miclle/cabinet/references/README.md

# 唱片机柜参考图片

本目录保存用户提供的柜子参考图，作为外观、分区及工艺讨论依据。图片原文件名标注来自小红书作者「四碗饭」，主题为「黑胶唱片机柜，大约可以放300张碟子」；目前没有原帖链接。保留图片中的文字与水印，未修改图片内容。

## 图片索引

命名采用 `原序号-英文内容描述.jpg`。原始资料没有第 9 张，保留编号空缺，不将其余图片前移。

原文件名统一为 `黑胶唱片机柜，大约可以放300张碟子_<序号>_四碗饭_来自小红书网页版.jpg`。

| 原序号 | 当前文件 | 内容与用途 |
|---|---|---|
| 1 | [01-cabinet-styled-front-angle.jpg](01-cabinet-styled-front-angle.jpg) | 搭配唱片机与音箱的正面斜视，整体风格参考 |
| 2 | [02-cabinet-front-view.jpg](02-cabinet-front-view.jpg) | 空柜正视，观察分区及立面比例 |
| 3 | [03-cabinet-open-door-angle.jpg](03-cabinet-open-door-angle.jpg) | 开门斜视，观察层板、门扇及侧板 |
| 4 | [04-cabinet-rear-layout-cable-clips.jpg](04-cabinet-rear-layout-cable-clips.jpg) | 背面分区与理线夹 |
| 5 | [05-cabinet-living-room-scene.jpg](05-cabinet-living-room-scene.jpg) | 客厅使用场景与人体比例参考，不能据此确定尺寸 |
| 6 | [06-cabinet-open-door-speaker-scene.jpg](06-cabinet-open-door-speaker-scene.jpg) | 开门状态的设备与音箱搭配 |
| 7 | [07-cabinet-storage-layout.jpg](07-cabinet-storage-layout.jpg) | 顶部唱片槽、左下抽屉及右侧设备／唱片格的用途说明 |
| 8 | [08-cabinet-styled-front-wide.jpg](08-cabinet-styled-front-wide.jpg) | 较完整的正面场景，观察底部留空与两侧落地板 |
| 10 | [10-cabinet-front-side-panel.jpg](10-cabinet-front-side-panel.jpg) | 正面斜视，观察整块侧板、圆角及门框 |
| 11 | [11-record-bin-top-detail.jpg](11-record-bin-top-detail.jpg) | 顶部唱片槽与分隔杆 |
| 12 | [12-record-bin-brass-divider-detail.jpg](12-record-bin-brass-divider-detail.jpg) | 铜色分隔杆及端部安装细节；图中文字称为铜件 |
| 13 | [13-slatted-door-detail.jpg](13-slatted-door-detail.jpg) | 竖向格栅木条、间距与圆弧表面 |
| 14 | [14-slatted-door-mortise-tenon-detail.jpg](14-slatted-door-mortise-tenon-detail.jpg) | 木条端部与门框榫接细节 |

## 初步结构判断

- **外观**：胡桃木色，左右连续侧板向下落地、向上略高出台面；前后上角圆润。第 3、4、10 张结合观察，侧板靠墙后端略高，背部横向构件的上沿低于侧板后端；照片有透视，不能据此量出准确高差。左侧横向木纹面板与右侧细密竖格栅构成立面对比，下部横梁和离地留空使外形较轻。
- **左上**：从顶部取放的唱片槽，前挡板遮住唱片下半部，内部有两根铜色分隔杆。没有证据表明它是抽屉。
- **左下**：用于唱片的拉出式抽屉，上方留出封面展示和取放开口；用途由第 7 张的文字说明支持，抽屉滑轨与内部构造未展示。
- **右上**：唱片机置于顶面；格栅门后上层原用于功放。
- **右下**：格栅门后的唱片竖放区；门在右侧开启，五金型号、开角及安装尺寸未知。
- **背面**：设备区大面积敞开，左侧唱片区可见挡板，顶部／底部横向构件上设理线夹。需要另外确定抗侧向变形的连接方式，不能将敞背照片直接当作完整结构图。
- **材料与工艺**：图片文字宣称北美黑胡桃原木、铜件及格栅榫接；细节图能观察到木条端部嵌入门框，但无法由照片核实全部材质、榫深或胶合方式。

## 与目标唱片机的适配

2026-10-12 核对了[目标唱片机项目](https://github.com/miclle/vinyl-record-player)的 `main`，版本为 `83f002c90ee65a06adc0de353f203472fbe2baea`；本地对应 checkout 的 HEAD 相同且无未提交变更。

依据该版本的 [README](https://github.com/miclle/vinyl-record-player/blob/83f002c90ee65a06adc0de353f203472fbe2baea/README.md)与参数资料：

| 项目 | 当前设计数据 | 对柜子的影响 |
|---|---|---|
| 唱片机宽度 | 450 mm | 右上台面必须按净可用宽度定尺寸，计入侧板、挡边与操作余量 |
| 箱体深度／总包络深度 | 350／363.8 mm | 总深含前侧铭牌和后凸合页，尚不含外接插头和线缆；不能只按 350 mm 定柜深 |
| 闭盖高度 | 210.7 mm | 柜面高度需结合实际操作位置确定 |
| 翻盖展示角 | 70° | 需要检查完整开盖轨迹与后挡板、墙面的关系；该角度并非实物限位／悬停验证 |
| 扬声器布局 | 两全频朝前，低音朝下 | 唱片机放在开放顶面，保留原脚垫，避免挡边遮住前声路或挤占底部空间 |
| 低音最低点距承托面 | 当前模型 19.5 mm | 不在机身下铺厚垫或加构件而侵占该间隙；柜面振动、共振及实际声效仍需试摆验证 |
| 后部接口 | 电源接口、倒相口等 | 后挡板和靠墙距离应按实物接线、倒相口位置与开盖包络共同核对 |

目标是一体式唱片机，自带功放与扬声器，因此参考柜右上内部的功放格可以保留外观分层，转作配件或唱片收纳；是否另放设备尚未确定。

## 下一步定尺寸的依据

优先保留侧板轮廓、左侧唱片槽／抽屉、右侧竖格栅门和胡桃木色关系，再按目标机器的实际包络调整宽深，避免按照片比例直接缩放。

作为后续草模的起点，可以先试右上净台面宽约 500～530 mm、有效承托深约 420～450 mm；这些是基于现有机身尺寸增加余量的设计假设，尚未做 CAD 或实物适配验证，也不是原柜尺寸。柜体总宽还需叠加左侧唱片区、侧板、中隔板和门框；总深还需计入后挡边等构件。柜面高度待结合使用者站姿／坐姿与开盖操作确定。

正式结构设计前需要补齐：

1. 摆放位置允许的总宽、总深、总高，以及背部靠墙条件。
2. 期望唱片容量、实际套封最大外廓、单／双碟与厚盒比例。原图标题的「约 300 张」仅为来源宣称，不能作为本柜容量结论。
3. 板材与实际厚度、连接工艺、格栅截面／间距、门与抽屉五金。承载需按唱片、设备和抽屉的实际重量核算。
4. 唱片机实物闭盖与开盖包络、插头突出长度、线缆弯曲空间、底部声路，以及抽屉拉出和门扇开启的空间。
5. 敞背柜体的抗侧向变形方案，满载抽屉拉出时的稳定性与防倾倒措施。

当前资料没有尺寸标注；以上分析不构成加工图或已验证的承载设计。

## 当前方案与参考图的差异

用户已要求柜子背后全部封闭。当前模型采用完整的 20 mm 厚背板，左右收纳区均封背；背板外表面按用户要求距侧板后沿内退 10 mm，位于 Y=430～450，内退量为当前方案值，并非照片实测；上文的敞背和理线横梁描述只记录原参考图片。侧板上沿先按前端名义高 810 mm、后部最高 830 mm（前 R20、后 R10，后立边顶高 820 mm），背板顶高 810 mm 建模，保留后端略高与背板退低的外观关系；两处 20 mm 高差为设计假设，非原柜实测。模型另有四个脚垫，左右侧板前后各一；暂按 Ø18×5 mm，侧板下缘离地 5 mm，柜体总高仍为 830 mm。圆角半径和脚垫尺寸均为设计值，非照片测量值。电源线现按背板上方绕出、沿背面三个开口理线夹向下走线加入方案占位；线材和夹子的实际规格尚未确认。当前布局与空间验证以项目根目录的 [README](../README.md) 为准。
