miclle/cabinet/designs/top-bin/previews/front.png

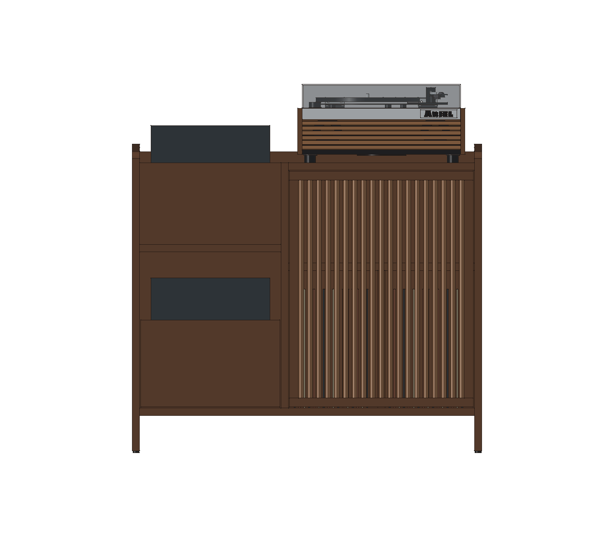
designs/top-bin/previews/front.png
