miclle/cabinet/designs/top-bin/previews/side-profile.png

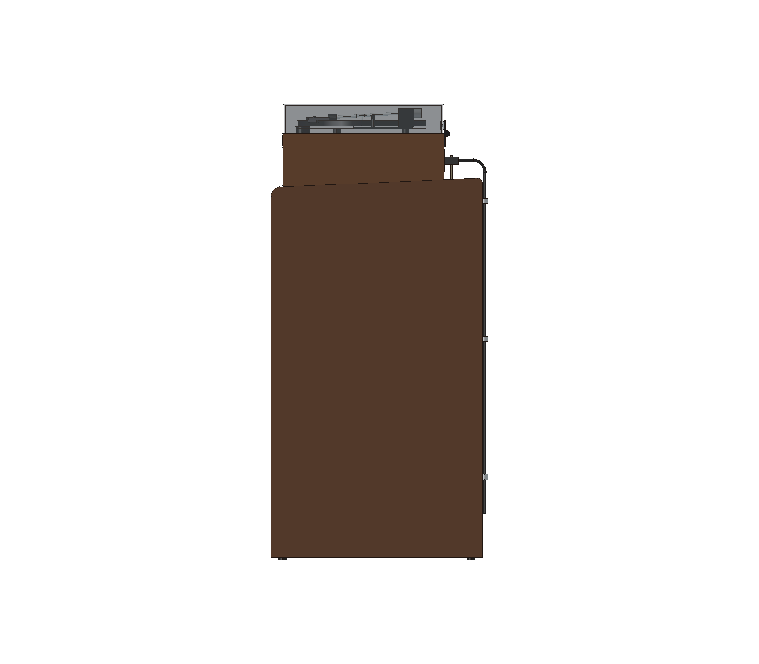
designs/top-bin/previews/side-profile.png
