miclle/cabinet/previews/foot-pads.png

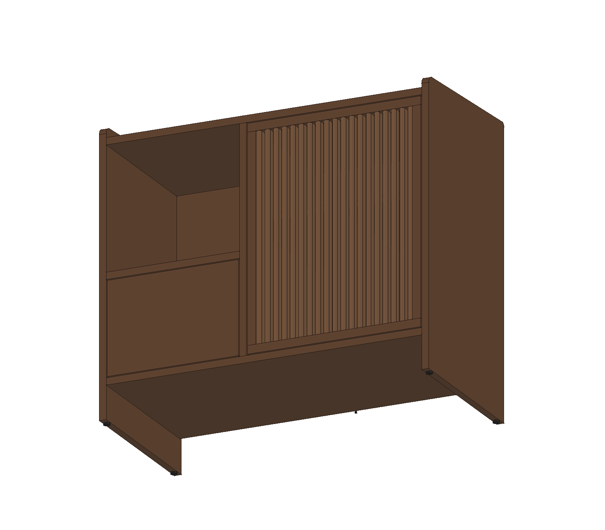
previews/foot-pads.png
