miclle/cabinet/previews/front.png

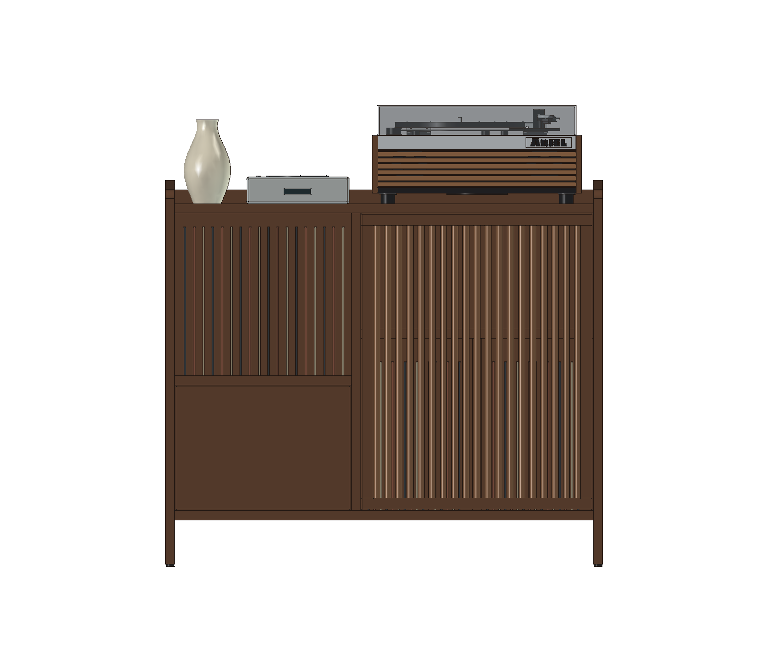
previews/front.png
