miclle/cabinet/previews/rear.png

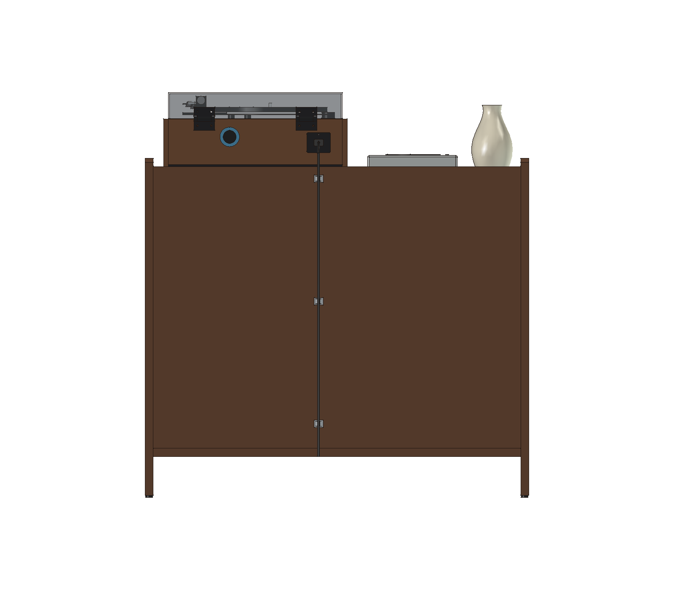
previews/rear.png
