miclle/cabinet/previews/storage-inspection.png

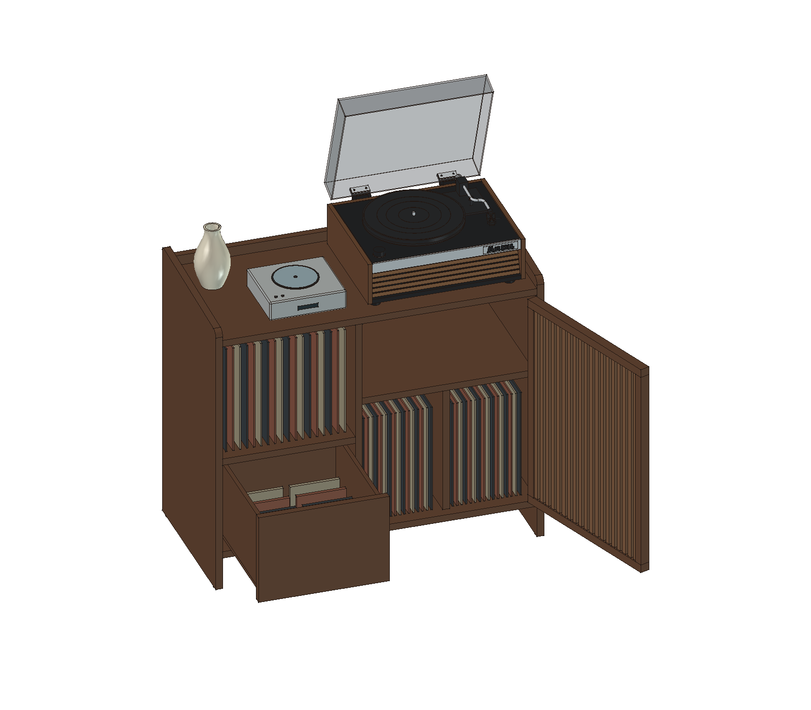
previews/storage-inspection.png
