miclle/cabinet/references/01-cabinet-styled-front-angle.jpg

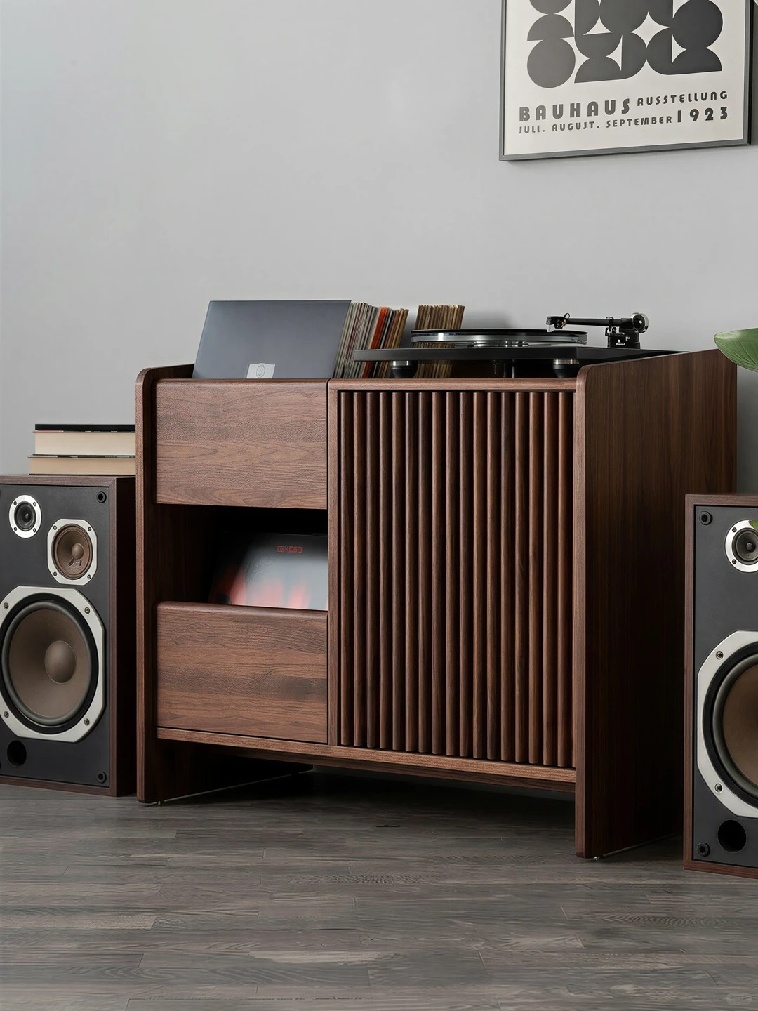
references/01-cabinet-styled-front-angle.jpg
