miclle/cabinet/references/02-cabinet-front-view.jpg

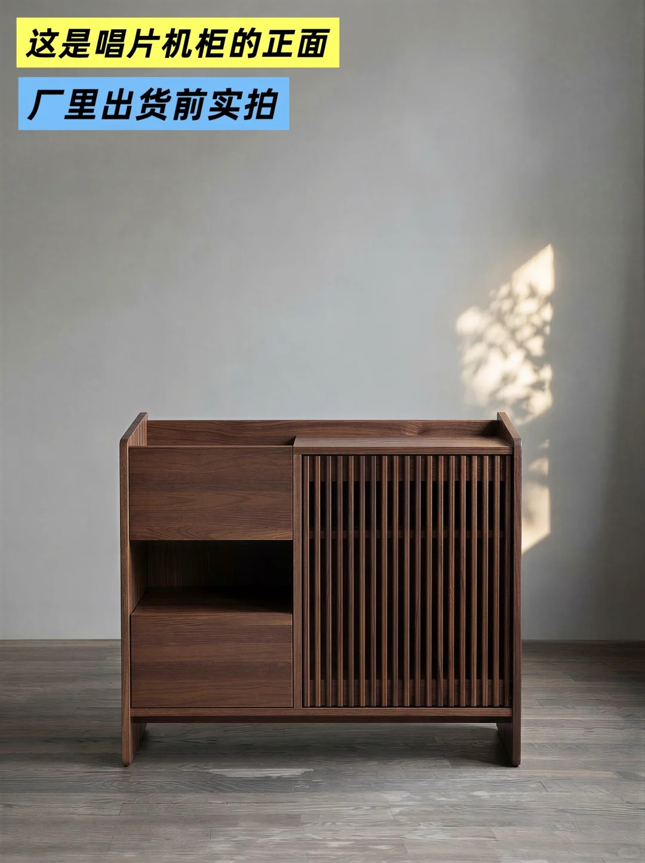
references/02-cabinet-front-view.jpg
