miclle/cabinet/references/03-cabinet-open-door-angle.jpg

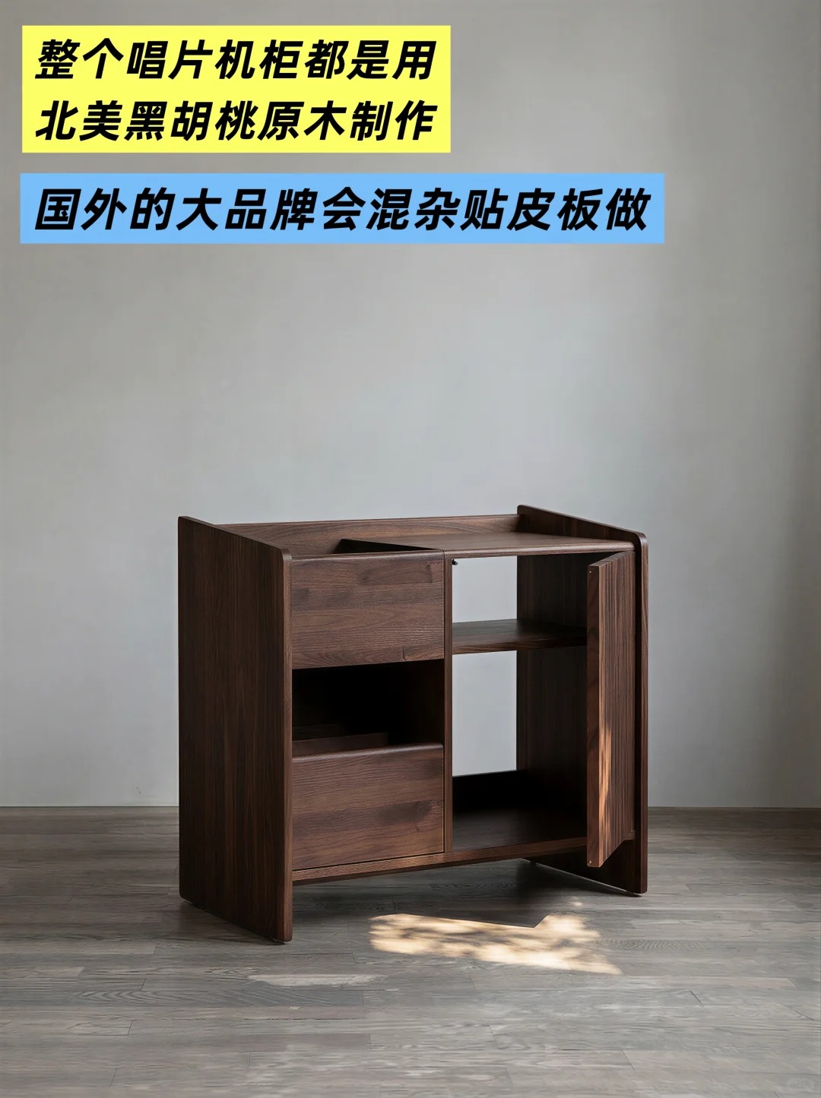
references/03-cabinet-open-door-angle.jpg
