miclle/cabinet/references/04-cabinet-rear-layout-cable-clips.jpg

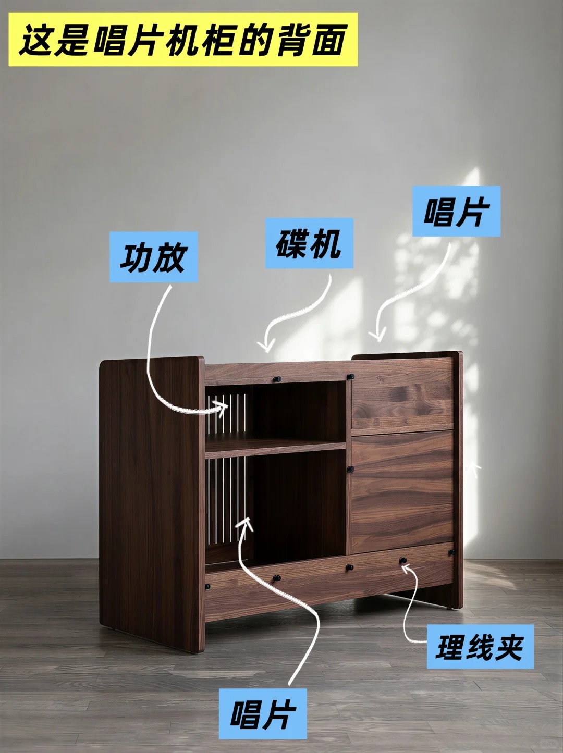
references/04-cabinet-rear-layout-cable-clips.jpg
