miclle/cabinet/references/05-cabinet-living-room-scene.jpg

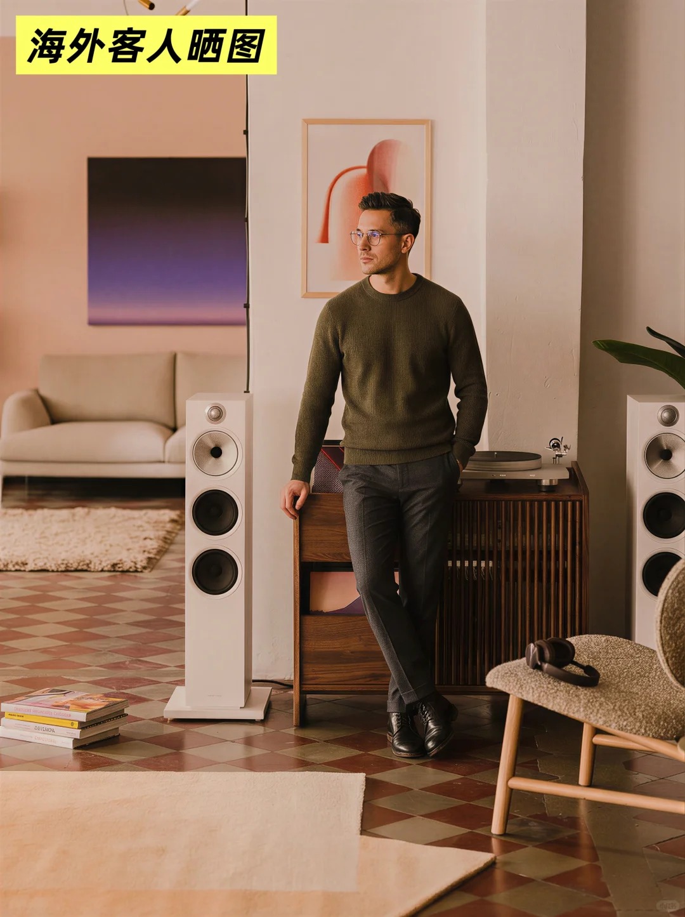
references/05-cabinet-living-room-scene.jpg
