miclle/cabinet/references/06-cabinet-open-door-speaker-scene.jpg

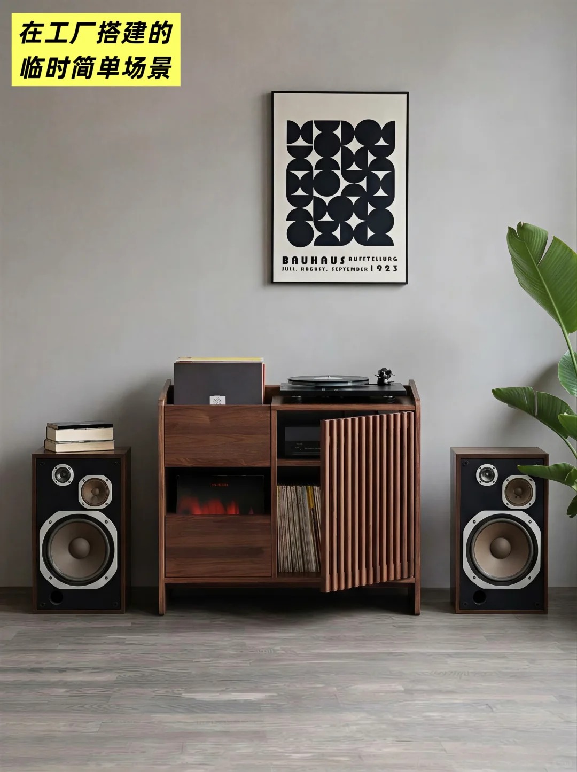
references/06-cabinet-open-door-speaker-scene.jpg
