miclle/cabinet/references/07-cabinet-storage-layout.jpg

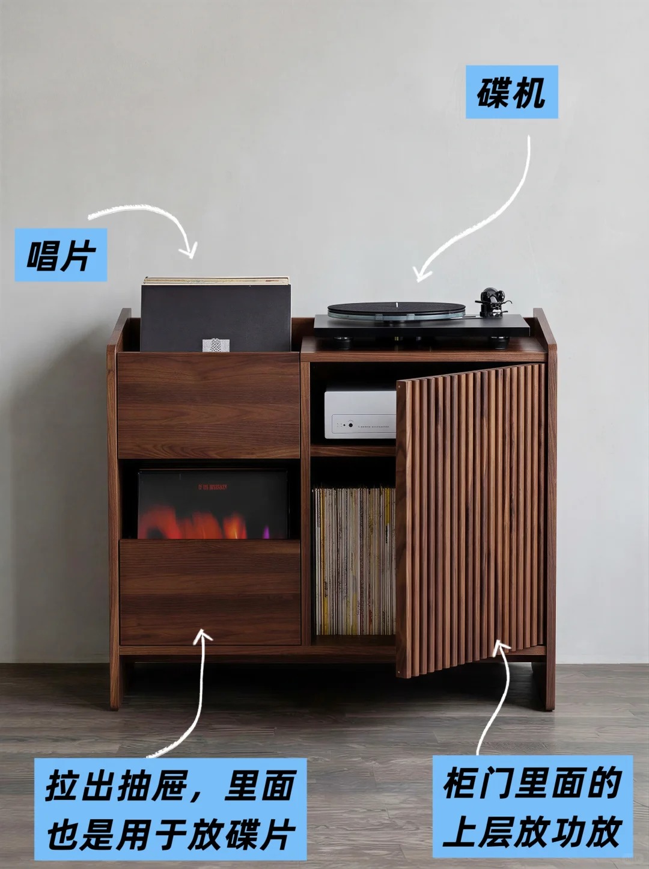
references/07-cabinet-storage-layout.jpg
