miclle/cabinet/references/08-cabinet-styled-front-wide.jpg

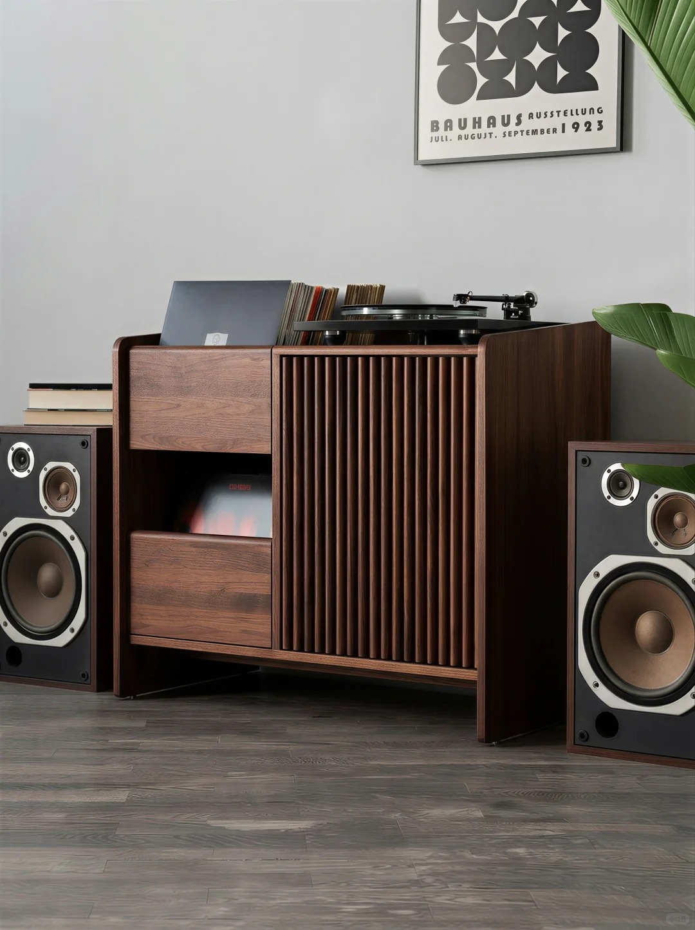
references/08-cabinet-styled-front-wide.jpg
