miclle/cabinet/references/10-cabinet-front-side-panel.jpg

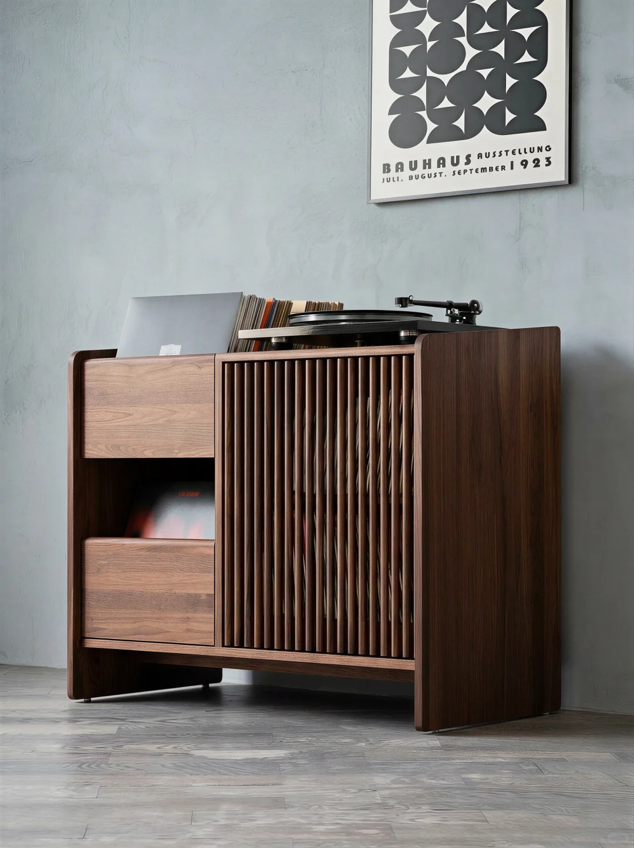
references/10-cabinet-front-side-panel.jpg
