miclle/cabinet/references/11-record-bin-top-detail.jpg

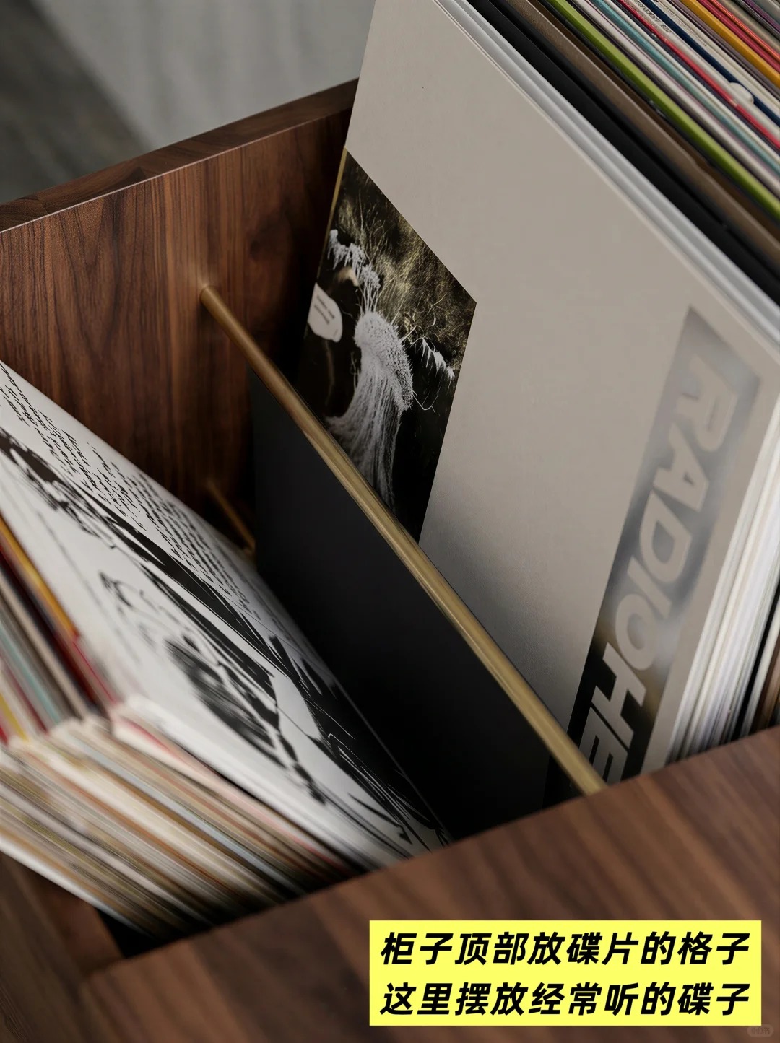
references/11-record-bin-top-detail.jpg
