miclle/cabinet/references/12-record-bin-brass-divider-detail.jpg

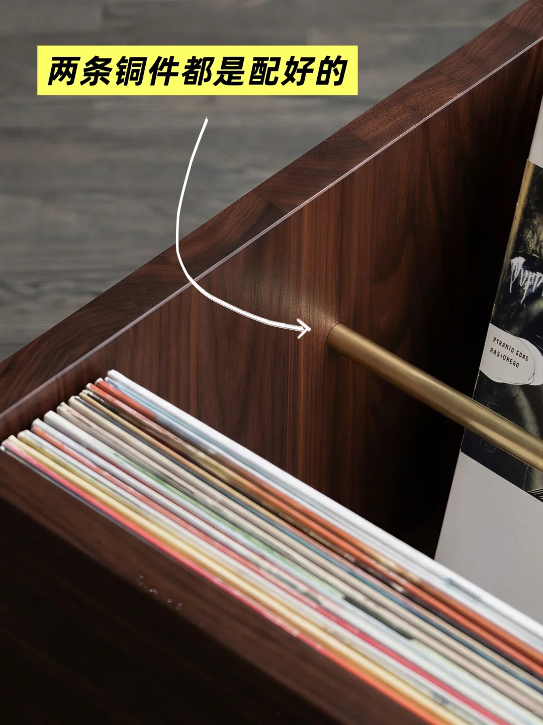
references/12-record-bin-brass-divider-detail.jpg
