miclle/cabinet/references/13-slatted-door-detail.jpg

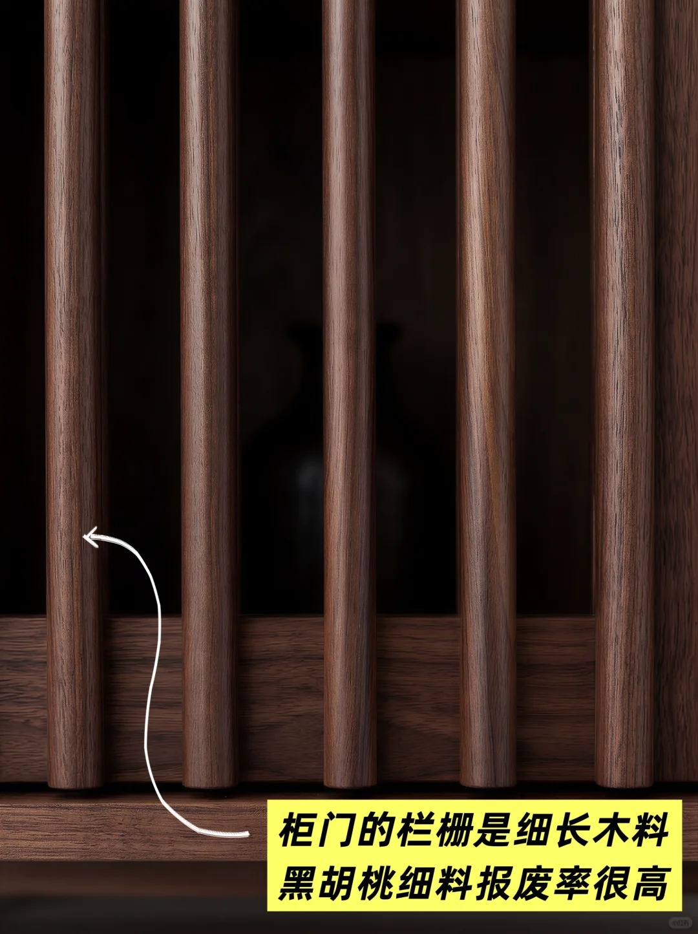
references/13-slatted-door-detail.jpg
