miclle/cabinet/references/14-slatted-door-mortise-tenon-detail.jpg

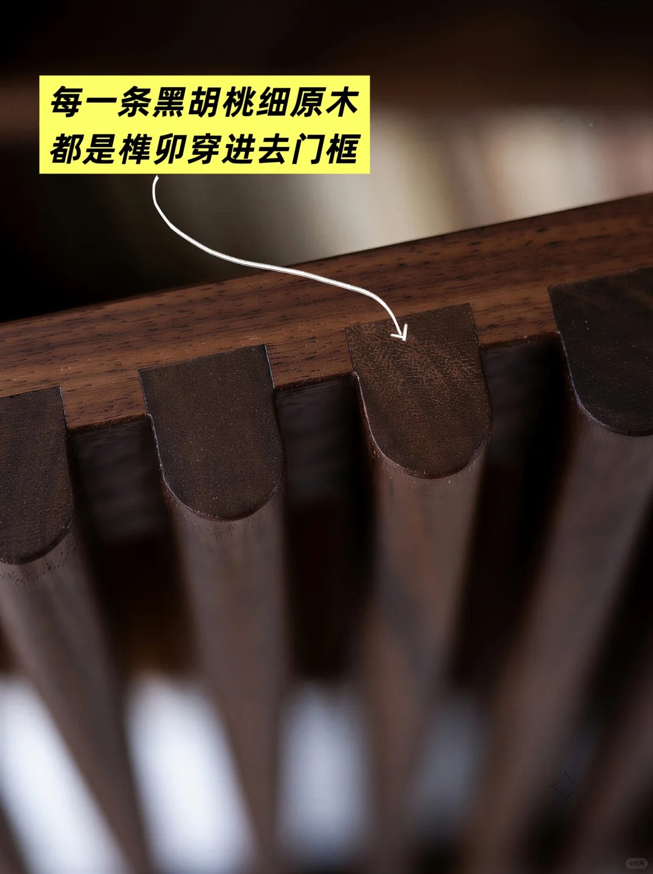
references/14-slatted-door-mortise-tenon-detail.jpg
