miclle/cabinet/designs/top-bin/docs/materials-and-hardware.md

# 方案A · 柜子板材尺寸与制作细化清单

本清单只描述顶部唱片槽方案A，恢复自`f6a8c35`交付；整台面方案B见[独立清单](../../../docs/materials-and-hardware.md)，整体差异见[双方案对比](../../../docs/design-comparison.md)。

本清单按当前 `940 × 460 × 830 mm` 方案整理，2026-10-14 从保存的 [cabinet.FCStd](../cad/cabinet.FCStd) 临时副本回读，统一恢复闭盖、关门、关抽屉姿态后核对尺寸。模型文件 SHA-256 为 `7d4d9bd0af57f242431627ec76281da54f3599f52e46b485d89af76963a05ced`；此次加入电源线与三个背面理线夹的方案占位；木料尺寸保持背板内退10的方案。

**以下是当前 CAD 的成品几何包络尺寸，用于核对方案、估料和与木工讨论；还不是可直接下单的开料表。** 模型尚未加入榫头、槽口、拼板、封边、五金孔和加工余量。连接方式或五金改变后，应先改模型，再更新清单。

逐件数据见 [wood-parts.csv](../cad/wood-parts.csv)，共 39 行、每行 1 件，保留 FreeCAD 对象名、尺寸方向及闭合姿态的定位坐标。唱片机本体、唱片占位和房间参考体不计入柜子材料。电源插头、线缆和三个理线夹属于辅件占位，未计入39件木料；尺寸见下方五金表。

## 尺寸与位置约定

- 全部尺寸单位为 mm，板面两边与厚度分列；表中「宽、深、高」说明板面方向，不按数值大小重新排序。
- 面向柜子正面：X 从左向右，Y 从前向后，Z 从地面向上。原点是左侧板外表面前沿正下方的地面点（侧板下缘 Z=5）；CSV 的位置是每个实体包络的最小 X、Y、Z，不是钻孔定位点。
- 板厚是当前模型的成品厚度，采购时需确认实际板厚。不能直接用 18 mm 板替代模型中的 20 mm 板而沿用开料及五金位置。
- 侧板下缘离地 5，木料包络高 825；上部最高点离地 830，前端名义上沿 810，前上角 R20、后上角 R10，均与斜上沿相切；后立边顶高 820。侧板需另出轮廓图，`825 × 460` 只是包络。四个 Ø18×5 脚垫补足底部 5，柜子总高仍为 830。

## 柜体板材

| 编号 | 零件／CAD 对象 | 板面尺寸 | 厚度 | 数量 | 位置与说明 |
|---|---|---|---:|---:|---|
| B01 | 左、右侧板／SideLeft、SideRight | 高 825 × 深 460 | 20 | 2 | 左板 X=0～20，右板 X=920～940；下缘 Z=5；前名义810、最高830、后立边820；前 R20、后 R10 |
| B02 | 底板／Bottom | 宽 900 × 深 450 | 20 | 1 | 两侧板之间；下表面 Z=100，上表面 Z=120；后沿 Y=450，与背板外面对齐 |
| B03 | 中隔板／Middle | 高 660 × 深 430 | 20 | 1 | X=400～420；底 Z=120，顶 Z=780，后沿抵背板内面 |
| B04 | 唱片机台面／PlayerTable | 宽 500 × 深 430 | 20 | 1 | 中隔板右侧；底 Z=760，承托面 Z=780 |
| B05 | 左上唱片槽底／BinFloor | 宽 380 × 深 430 | 20 | 1 | 左侧板与中隔板之间；底 Z=540，上表面 Z=560；加前挡板后槽内净深410 |
| B06 | 唱片槽前挡板／BinFront | 宽 380 × 高 220 | 20 | 1 | 左上正面 Y=0～20；底 Z=560，顶 Z=780 |
| B07 | 整幅封闭背板／BackPanel | 宽 900 × 高 690 | 20 | 1 | Y=430～450，外面距侧板后沿内退10；底 Z=120，顶 Z=810；比侧板最高点低20，左右收纳区均封闭 |
| B08 | 右侧层板／RightShelf | 宽 500 × 深 390 | 20 | 1 | Y=30～420；底 Z=490，上表面 Z=510；后沿距背板内面10 |
| B09 | 右下可拆竖隔板／RecordDivider | 高 370 × 深 390 | 20 | 1 | X=660～680，Y=30～420，Z=120～490；两侧净宽各240；装拆间隙待加入 |

柜体共 **10 件，均厚20**。背板自身仍为900×690×20，只改变前后位置；六块相关板件缩短，唱片槽净深410，右侧层板及竖隔板后方仍留10。当前连接面按相接建模，未伸入相邻板的榫头或槽口；例如底板900宽、背板900宽均不能直接当作入槽后的开料宽度。

## 左下抽屉

| 编号 | 零件／CAD 对象 | 板面尺寸 | 厚度 | 数量 | 位置与说明 |
|---|---|---|---:|---:|---|
| C01 | 外面板／DrawerFront | 宽 374 × 高 234 | 20 | 1 | X=23～397，Y=0～20，Z=123～357；相对380×240名义面口四周各留3 |
| C02 | 底板／DrawerFloor | 宽 354 × 深 384 | 10 | 1 | X=33～387，Y=20～404，Z=140～150；当前在四壁下方，未做入槽 |
| C03 | 左、右箱侧／DrawerLeft、DrawerRight | 深 384 × 高 190 | 12 | 2 | X=33～45及375～387，Y=20～404，Z=150～340 |
| C04 | 箱内前板、后板／DrawerInnerFront、DrawerRear | 宽 330 × 高 190 | 12 | 2 | 两侧板之间；Y=20～32及392～404，Z=150～340 |

抽屉共 **6 件**。箱体外宽354、外深384；内宽330、内深360，内底面离地150。侧壁高190，较大的唱片套会高出箱侧，这是当前展示抽屉的布局。左右滑轨预留均为 `(380−354)÷2=13`。

面板、内前板和底板是三个独立零件，不能漏掉内前板。若改成底板四边入槽，需重算底板尺寸、槽高及剩余边厚；不能直接把354×384的底板再塞入现有箱壁。

## 右侧格栅门

| 编号 | 零件／CAD 对象 | 板面尺寸 | 厚度／前后深度 | 数量 | 位置与说明 |
|---|---|---|---:|---:|---|
| D01 | 左、右竖框／DoorLeft、DoorRight | 高 586 × 宽 24 | 28 | 2 | X=423～447及893～917，Z=147～733；目前夹在上下横框之间 |
| D02 | 上、下横框／DoorTop、DoorBottom | 长 494 × 高 24 | 28 | 2 | X=423～917；下框 Z=123～147，上框 Z=733～757 |
| D03 | 竖格栅／DoorSlat01～19 | 高 586 × 宽 14 | 24 | 19 | Z=147～733；首根 X=447，随后每24一根，木条净间距10 |

门扇共 **23 件木料**，整体宽494、高634、框深28。内部格栅区宽 `494−24×2=446`，等于 `19×14+18×10`。

格栅是前圆后平的 D 形截面：正面半圆 R7，后接17深的矩形，总包络14×24，不能把它当作整根圆柱。表中的586为框间净高；模型的木条和竖框端部均没有榫头。确定榫接后，毛坯长应计入两端榫长，同时给横框相应开榫眼。上下横框、竖框的搭接方式若改动，也需重算长度。

## 数量与估料汇总

| 成品厚度／深度 | 件数 | 用途 | 矩形包络板面面积合计 |
|---:|---:|---|---:|
| 20 | 11 | 柜体10件、抽屉外面板1件 | 2.957616 m² |
| 12 | 4 | 抽屉四壁 | 0.271320 m² |
| 10 | 1 | 抽屉底板 | 0.135936 m² |
| 28 | 4 | 门框 | 0.051840 m² |
| 24 | 19 | D形格栅，以矩形包络计 | 0.155876 m² |
| **合计** | **39** | 10件柜体＋6件抽屉＋23件门木料 | **3.572588 m²** |

按这些包络计算的木料体积约 **0.0690 m³**，未计榫头、拼板修边、刨削、锯缝、缺陷剔除、纹理配对及备料。该数值不能直接换算为采购几张整板；还需按实际材料规格、木纹方向和工艺排料。侧板按外包矩形计，格栅按未铣圆毛坯截面计。

建议的纹理方向是：两块侧板沿高度，台面／层板沿宽度，抽屉面板与唱片槽前挡板保留参考图的横纹，门框与格栅顺零件长向。背板材质、拼板方向及饰面接缝需单独确定。

## 实际制作需要细化的连接

| 部位 | 当前模型状态 | 建议细化方向 | 会影响的尺寸／验证 |
|---|---|---|---|
| 底板—侧板—中隔板 | 仅端面／板面相接 | 选择承力槽口配合圆榫、松榫或合适连接件；先形成明确的竖向承载与抗侧摆路径 | 槽深、入槽长度、榫位、紧固件埋深；底板和中隔板开料尺寸 |
| 台面、槽底与右层板 | 无榫槽和支撑件 | 台面与槽底设可靠承托；右层板当前按固定层板讨论，是否可调需另定 | 层板端部入槽量；若可调则需层板托孔及承载核对 |
| 整幅背板 | 四周相接，厚20 | 材料先定：可讨论胡桃木饰面胶合板；若用实木拼板，需按纹理和含水率变化设计浮动／长孔连接，不能把四边跨纹全部刚性胶死 | 背板槽／企口、浮动缝、可拆固定和侧向刚度；外表面内退10、顶高810；槽口与浮动缝需另细化 |
| 门框四角与19根格栅 | 仅接触，未切榫眼 | 做角部榫接／松榫及格栅端榫；出定位模板，保证19根等距；先做一段框条与木条样件 | 586净长加榫长、横框有效宽、榫眼间剩余木料、门扇对角线及翘曲 |
| 抽屉四壁、底板、外面板 | 四壁对接，底板在下方 | 选择箱角连接；唱片较重，底板承托与固定要明确；外面板预留可调整连接 | 四壁接头长度、底板入槽尺寸、面板调节孔、实际负载和底板挠度 |
| 可拆竖隔板 | 370高紧贴上下板，无定位 | 加防窜定位及装拆间隙；优先可拆销／扣件，保持可调整 | 高度不能直接紧配370；拆卸路径、扣件凸出和唱片净空 |
| 侧板脚垫、防倾倒 | 已建四个 Ø18×5 脚垫，未设安装孔、调平或墙固件 | 脚垫材质与固定方式按实物确定；墙固件连接到承力部位 | 脚垫中心 X=10／930、Y=25／435；侧板下缘 Z=5，总高830；墙距80、锚固方式及满载开抽屉稳定性 |

背板材质与连接是优先决策：整幅900×690的实木板不能只按几何尺寸讨论。USDA《Wood Handbook》说明，木材在使用中会随含水率变化而发生尺寸变化，涂层只能减缓、不能阻止这一过程；实际含水率应匹配使用环境。这里提出浮动或长孔连接是据此做出的设计建议，具体留量还需按选定木材与环境计算。[USDA 木材含水率与尺寸变化章节](https://research.fs.usda.gov/download/treesearch/7143.pdf)

## 五金与适配问题

下面的数量用于方案准备，尚未指定最终采购型号；紧固件数量应由连接详图和厂家孔位确定。

| 五金／辅件 | 方案数量 | 位置与待确认事项 |
|---|---:|---|
| 抽屉侧装滑轨 | 1副 | 左侧板内面、中隔板左面与抽屉两侧；核对每侧13空间、箱深384、箱宽354、载荷、实际行程和安装孔 |
| 窄叶平铰链或合适的非杯式铰链 | 暂估2～3只 | 门右竖框与右侧板；按门重、门宽及型号确定数量，先核对24宽框、28厚门和20厚侧板，重建真实转轴 |
| 门吸／反弹开启系统 | 1套，二选一方案 | 门左侧闭合处；普通门吸配暗扣，反弹系统则需同时选兼容铰链；是否阻尼也一起确定 |
| 抽屉拉手／暗扣 | 1处 | 优先讨论外面板上沿背侧暗扣，保留正面外观；需验证手指空间、面板剩余厚度及操作力 |
| 唱片槽铜色分隔杆 | 2根，模型Ø8、跨距380 | 中心高 Z=680，Y=160及300；380是净跨距，实际截长需加两端嵌入量或按端座扣减 |
| 分隔杆端部连接 | 4端 | 选择嵌孔或端座；确认孔深、容差、拔脱固定及装配顺序，不能先把两边板封死后再塞入定长杆 |
| 可拆竖隔板定位件 | 1套 | 上下定位方式待定，件数随方案确定；不应妨碍抽取唱片 |
| 柜脚垫 | 4个 | 两侧板底部前后各一；模型 Ø18×5，中心 X=10／930、Y=25／435，Z=0～5；材质、固定和承载待定，未设计调平机构 |
| 电源线／插头 | 1套方案占位 | 插头22×30×16，线Ø6、R25；模型段中心线长约815.29，末端离地100；实物型号、总长、插拔余量与墙插位置待核对 |
| 背面开口理线夹 | 3个方案占位 | 底座22×3×18贴Y=450；孔Ø8、外径Ø14、夹身高12、开口宽6；线孔中心X=515、Y=465、Z=780／480／180；固定方式与材质待定，未开螺钉孔 |
| 防倾倒墙固组件 | 暂按2处讨论 | 柜后上部两侧承力节点；实际数量／规格按墙体和受力方案确定，需跨越80墙距 |
| 连接件、螺钉、胶、缓冲垫 | 待连接图确定 | 特别核对12厚抽屉侧壁处的有效螺钉长度；材料、孔径、边距及胶合面由工艺确定 |

电源线采用背板上方绕出、沿外侧向下的路线，保持整幅背板无新增走线孔。理线夹最远超出侧板后沿约11.32；按当前墙距80布置，距墙最近约68.68。开盖0～70°每1°采样均无走线部件干涉，采样最小距离约44.30。以上验证针对固定占位，未验证线材弯曲性能、余线松弛或夹子固定强度；接口和线缆的实际适配需按实物确认。

### 滑轨：13 mm 侧空间不等于已适配

参考 Accuride **DB3832EC-D** 厂家数据，每侧安装空间为12.7加0.2～0.5，即12.9～13.2；当前13在此范围内。但该系列还要求抽屉宽度不超过滑轨长度：当前箱宽354，因此**不能直接把350长的该型号定为可用**。其350型号实际行程为310，400型号行程为406，不能把「全拉出」理解为所有长度都等于标称长度。[Accuride 厂家尺寸与限制，第1～2页](https://hs-europe.accuride.com/hubfs/Datasheets/DB3832-EC-D_en.pdf)

可继续比较允许354宽抽屉、适配384箱深且满足所需行程的其它型号；若选上述400长型号，需重新设计箱侧长度／安装支承与箱深。柜内前面板后方至背板有410深，只说明存在讨论400滑轨的空间，并不表示孔位和前后余量已通过。

当前模型仅检查了抽屉0～300的行程。拉出300时，箱后沿仍位于柜前沿后方104，后排唱片的向上取出、前倾抽出和手部操作还需试验；增加行程后也要重新核对防倾倒、运动干涉及邻近家具。滑轨额定载荷不能代替抽屉底板、螺钉与柜体连接的承载验证。

### 铰链：24 mm 窄框是当前约束

Blum 的常规杯式铰链参考图使用Ø35杯孔；当前竖框只有24宽，单独在这根框上无法容纳完整杯孔及周围固定木料，这是由现有尺寸得出的适配判断。不能仅因型号标称110°就采用它。[Blum 厂家杯孔参考图](https://d2.blum.com/services/BEC003/hingequickref_td_dok_bus_%24sen-us_%24aof_%24v1.pdf)

保留细框外观时，优先讨论能在窄框上安装的非杯式铰链；若坚持某种隐藏杯式铰链，需要局部加实木安装块或改宽竖框，再检查是否侵占格栅和唱片空间。现有示意转轴 `(917,0,123)` 与0～110°碰撞检查不代表任意真实铰链都能实现相同运动；需加入选定五金及实际轴线后重验。

## 制作前建议完成的顺序

1. 确定材料体系、成品厚度与实际木纹：主板、背板、抽屉底板是否实木／饰面板；确认含水率与拼板方式。
2. 先确定滑轨和铰链的具体型号，用实物或厂家安装图核对；必要时只调整箱体和隐藏连接，保留现有立面比例。
3. 画出底板、层板、背板、门框、格栅和抽屉的接头剖面，确定榫长、槽深、浮动缝、螺钉及装配顺序。
4. 将五金、接头和装拆间隙加入 CAD；核对关门缝、开门、抽屉全行程、后排唱片取放及承载／防倾倒。
5. 最后发布带木纹、加工基准、孔位、开槽、榫头、毛坯余量和数量的加工清单与零件图，再按实购材料排料。

本轮已同步背板内退 10 mm、底板深450、中隔板／台面／槽底板深430、右层板／可拆隔板深390；背板保持封闭，并保留侧板前 R20／后 R10 与四个脚垫。本次另加入电源插头、线缆和三个背面理线夹的方案占位。清单中的接头、实物五金及线材核对待办仍需完成。
