miclle/cabinet/designs/top-bin/cad/cabinet-closed.step

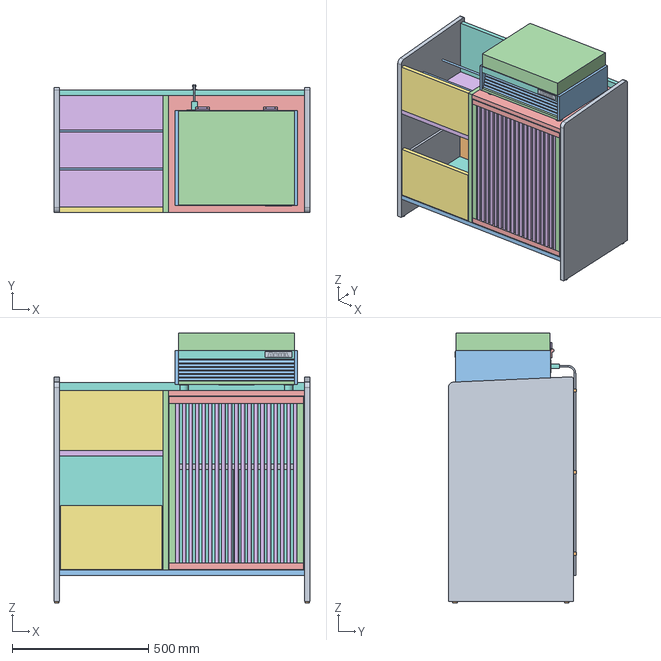
[picture p28: CAD file, 2026-10-16]
designs/top-bin/cad/cabinet-closed.step
940.0 x 471.3 x 990.7 mm
