miclle/cabinet/designs/top-bin/cad/cabinet.FCStd

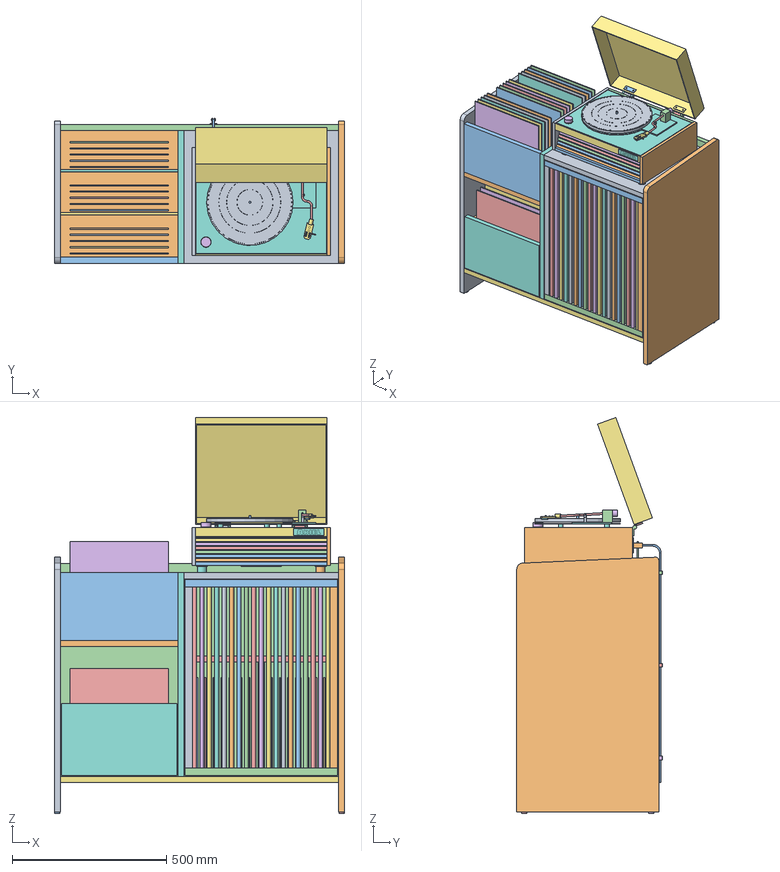
[picture p29: CAD file, 2026-10-16]
designs/top-bin/cad/cabinet.FCStd
940.0 x 471.3 x 1282.3 mm
左侧板 · 前R20后R10 · 底高5
右侧板 · 前R20后R10 · 底高5
柜脚垫 · Left/Front · Ø18×5
柜脚垫 · Left/Rear · Ø18×5
柜脚垫 · Right/Front · Ø18×5
柜脚垫 · Right/Rear · Ø18×5
底板 · 下表面距地 100
中隔板 · 后端抵背板内侧
唱片机台面 · 高 780
左上唱片槽底板
唱片槽前挡板 · 高 220
整幅封闭背板 · 内退10 · 顶高810 · 900×690×20
右侧层板 · 上格净高 250
下格可拆竖隔板 · 两格净宽 240
铜色唱片分隔杆
铜色唱片分隔杆001
格栅门左边框
格栅门右边框
格栅门上框
格栅门下框
格栅木条 01 · 14×24
格栅木条 02 · 14×24
格栅木条 03 · 14×24
格栅木条 04 · 14×24
格栅木条 05 · 14×24
格栅木条 06 · 14×24
格栅木条 07 · 14×24
格栅木条 08 · 14×24
格栅木条 09 · 14×24
格栅木条 10 · 14×24
格栅木条 11 · 14×24
格栅木条 12 · 14×24
格栅木条 13 · 14×24
格栅木条 14 · 14×24
格栅木条 15 · 14×24
格栅木条 16 · 14×24
格栅木条 17 · 14×24
格栅木条 18 · 14×24
格栅木条 19 · 14×24
抽屉面板 · 四周 3 mm 初值
抽屉底板 · 10 mm
抽屉左侧 · 12 mm
抽屉右侧 · 12 mm
抽屉内前板
抽屉后板
顶部唱片占位 · 不代表容量
顶部唱片占位 · 不代表容量001
顶部唱片占位 · 不代表容量002
顶部唱片占位 · 不代表容量003
顶部唱片占位 · 不代表容量004
顶部唱片占位 · 不代表容量005
顶部唱片占位 · 不代表容量006
顶部唱片占位 · 不代表容量007
顶部唱片占位 · 不代表容量008
顶部唱片占位 · 不代表容量009
顶部唱片占位 · 不代表容量010
顶部唱片占位 · 不代表容量011
顶部唱片占位 · 不代表容量012
顶部唱片占位 · 不代表容量013
顶部唱片占位 · 不代表容量014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
