miclle/cabinet/(list of files, cad)

Other CAD files:
cad/cabinet.FCStd
cad/cabinet-closed.step
