miclle/cabinet/(commit log)

2026-10-12 feat: add turntable cabinet CAD assembly
    Add the 940 x 460 x 830 mm cabinet with a closed back to study proportions, storage access and lid clearance.
    Include reference images, previews, rebuild tools and geometry verification reports.
2026-10-12 fix: match cabinet side and back profiles
    Raise the side top edges toward the rear and lower the closed back top to retain the reference silhouette within the existing overall dimensions.
    Refresh CAD, STEP, previews and documentation, and verify the saved profiles and motion clearances.
2026-10-12 docs: add rear upper cabinet previews
    Save the rear upper closed and open lid views and document their proportions and clearances.
    Include both camera poses in preview generation so the views can be reproduced.
2026-10-12 docs: add cabinet materials and hardware list
    Document dimensions, positions, thicknesses and quantities for all 39 cabinet wood parts, with a per-part CSV matched to the saved CAD model.
    Record joinery and hardware decisions needed before fabrication and link the checklist from README.
2026-10-13 feat(cad): refine cabinet and add cable routing
    Round rear side corners, add four feet and recess the back by 10 mm.
    Add plug, cable and clip envelopes with validated CAD and previews.
2026-10-13 docs: update cabinet layout and wiring notes
    Sync board dimensions, hardware assumptions and cable routing with the model.
    Document the checked clearances and retained physical verification limits.
2026-10-14 feat(cad): add full tabletop and front storage
    Move records below a continuous tabletop and retain the lower
    drawer for CDs and accessories. Add CD player and vase placeholders,
    updated previews, and saved-model validation.
2026-10-14 docs: update cabinet layout and placement notes
    Align layout dimensions, material totals and usage notes with
    the full tabletop, front record storage and display placeholders.
2026-10-14 docs: add record storage capacity estimates
    Document capacity by sleeve thickness, retrieval allowance and
    compartment width, with explicit counting and load limits.
2026-10-16 feat(cad): retain both cabinet layouts
    Restore the top-bin model, exports and previews alongside the full
    tabletop design. Share generation and readback tools while keeping
    parameters, output paths and validation reports separate.
